adilinden-oss/uino-motor/uino-motor-brd.png

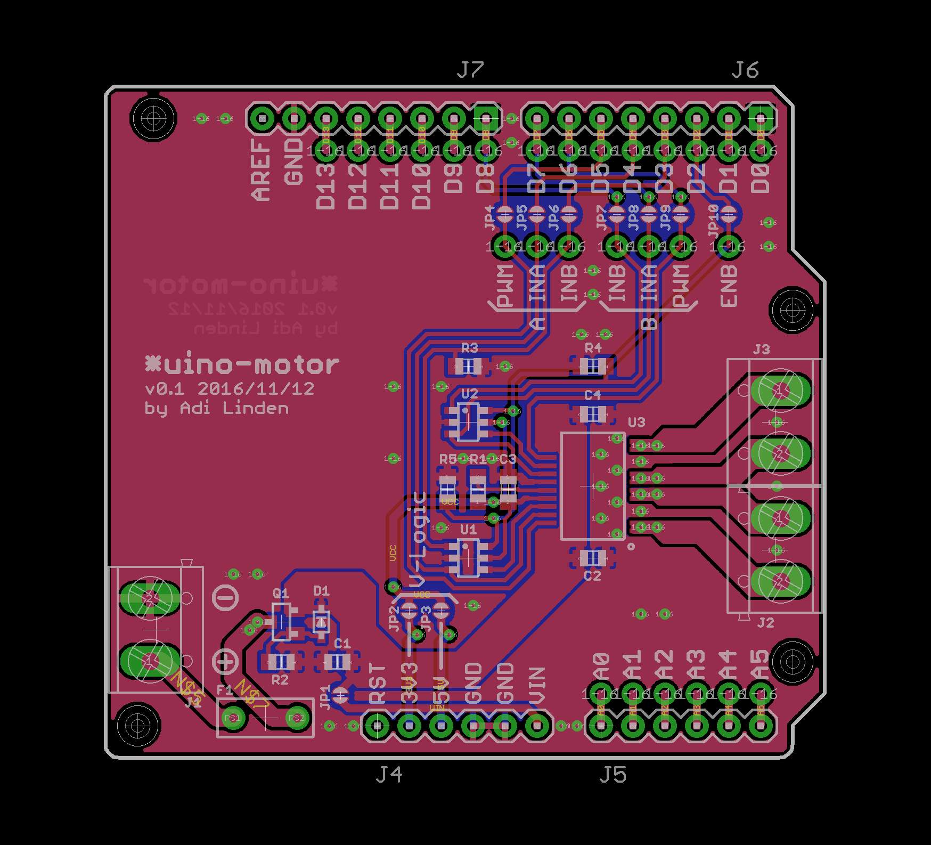
uino-motor-brd.png
