adilinden-oss/uino-motor/uino-motor-sch.png

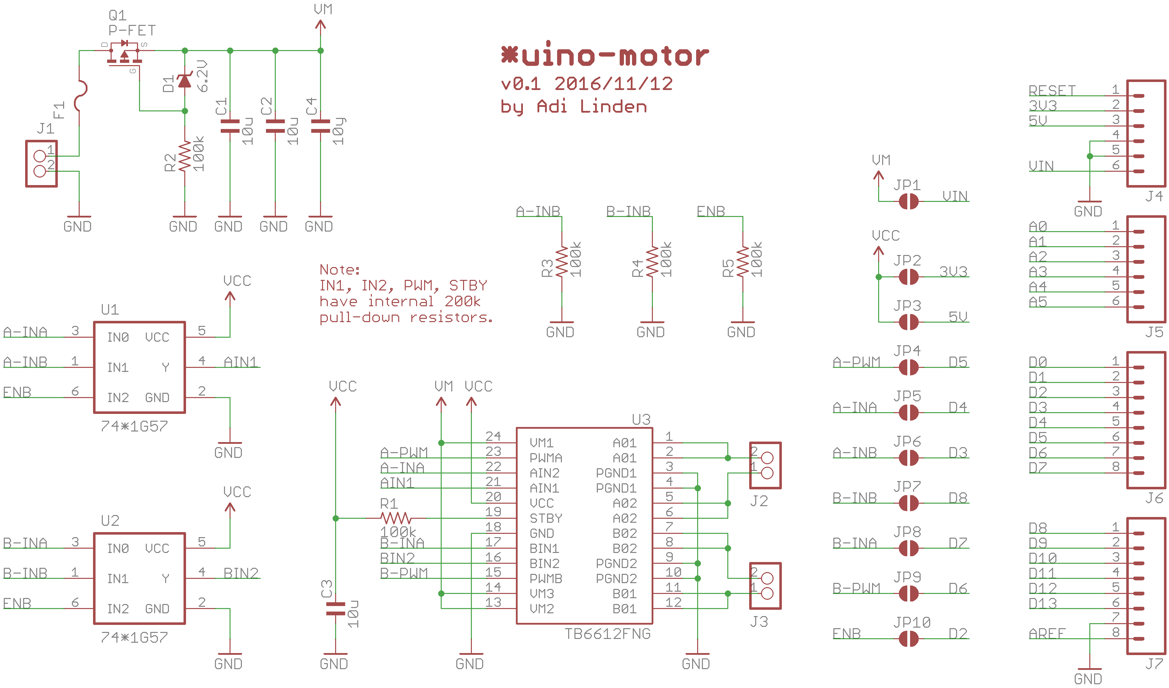
uino-motor-sch.png
