adilinden-oss/uino-motor/uino-motor_bom.xlsx

Parts | Qty | Value | Manufacturer Part Number | DigiKey Part Number | Package | Description
C1, C2, C3,C4 | 3 | 10u | CL21A106KOQNNNG | 1276-6455-1-ND | C0805 | 10µF ±10% 16V Ceramic Capacitor X5R 0805 (2012 Metric)
D1 | 1 | 6.2V Zener | DZ2J062M0L | DZ2J062M0LCT-ND | SOD323 | Zener Diode 6.2V 200mW ±5% Surface Mount SMini2-F5-B
F1 | 1 |  | 0ZRA0300FF1C | 507-1304-ND | 5mm | PTC Resettable Fuse 16V 3A Ih Through Hole Radial, Disc
J1, J2, J3 | 3 | Terminal | OSTTC022162 | ED2609-ND | 7.6x10.16mm | 2 Position Wire to Board Terminal Block Horizontal with Board 0.200" (5.08mm) Through Hole
J4, J5 | 2 | Header 1x6 | PPTC061LFBN-RC | S7004-ND | 1X06 | 6 Position Header Connector 0.100" (2.54mm) Through Hole Tin
J6, J7 | 2 | Header 1x8 | PPTC081LFBN-RC | S7006-ND | 1X08 | 8 Position Header Connector 0.100" (2.54mm) Through Hole Tin
Q1 | 1 | P-FET | SSM3J328R,LF | SSM3J328RLFCT-ND | SOT23 | MOSFET P-CH 20V 6A SOT23F
R1, R2, R3, R4, R5 | 5 | 100k | RC0805JR-07100KL | 311-100KARCT-ND | R0805 | RES SMD 100K OHM 5% 1/8W 0805
U1, U2 | 2 | 74*1G57 | 74LVC1G57W6-7 | 74LVC1G57W6-7CT-ND | SOT23-6 | Configurable Multiple Function Configurable 1 Circuit 3 Input SOT-26
U3 | 1 | TB6612FNG | TB6612FNG,C,8,EL | TB6612FNGC8ELCT-ND | SSOP24 | Motor Driver Power MOSFET Parallel 24-SSOP
