adilinden-oss/uino-motor/uino-motor.brd

## EAGLE design uino-motor.brd (2016-11-17)

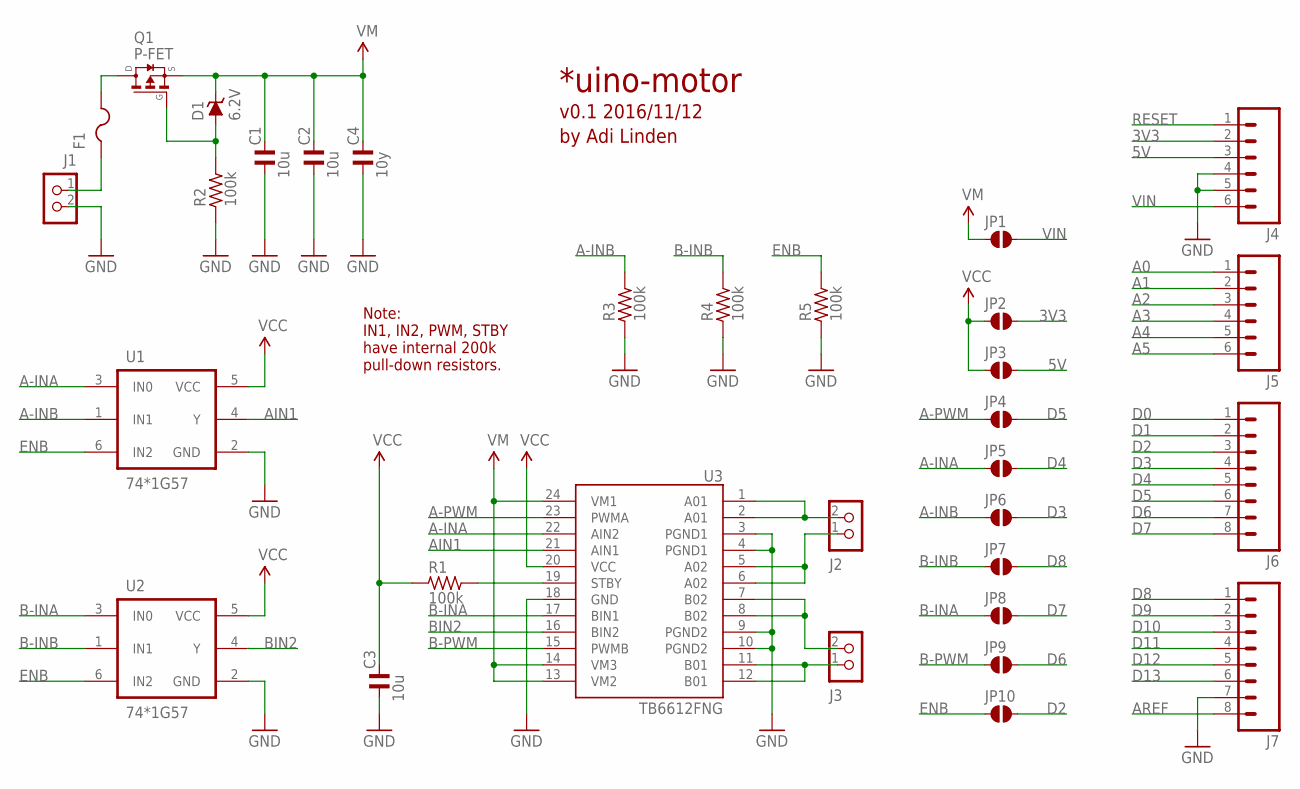
[picture p3: schematic uino-motor.sch]

Parts:
C1, C2, C3: 10u; C0805MP
C4: 10y; C0805MP
D1: 6.2V; SOD323
F1: FUSE_PTC-TH; PTC
J1, J2, J3: CON_TERMINAL_BLOCK_02-5MM; TERMINAL_BLOCK_2P_5
J4, J5: M06SIP; 1X06
J6, J7: M081X08; 1X08
JP1, JP2, JP3, JP4, JP5, JP6, JP7, JP8, JP9, JP10: SJ-035
Q1: P-FET; SOT23
R1, R2, R3, R4, R5: 100k; R0805MP
U1, U2: 74*1G57; SOT23-6
U3: TB6612FNG; SSOP24

Connections:
3V3: J4.2, JP2.2
5V: J4.3, JP3.2
A0: J5.1
A1: J5.2
A01: J2.2, U3.1 (A01), U3.2 (A01)
A2: J5.3
A02: J2.1, U3.5 (A02), U3.6 (A02)
A3: J5.4
A4: J5.5
A5: J5.6
A-INA: JP5.1, U1.3 (IN0), U3.22 (AIN2)
A-INB: JP6.1, R3.2, U1.1 (IN1)
A-PWM: JP4.1, U3.23 (PWMA)
AIN1: U1.4 (Y), U3.21 (AIN1)
AREF: J7.8
B01: J3.1, U3.11 (B01), U3.12 (B01)
B02: J3.2, U3.7 (B02), U3.8 (B02)
B-INA: JP8.1, U2.3 (IN0), U3.17 (BIN1)
B-INB: JP7.1, R4.2, U2.1 (IN1)
B-PWM: JP9.1, U3.15 (PWMB)
BIN2: U2.4 (Y), U3.16 (BIN2)
D0: J6.1
D1: J6.2
D2: J6.3, JP10.2
D3: J6.4, JP6.2
D4: J6.5, JP5.2
D5: J6.6, JP4.2
D6: J6.7, JP9.2
D7: J6.8, JP8.2
D8: J7.1, JP7.2
D9: J7.2
D10: J7.3
D11: J7.4
D12: J7.5
D13: J7.6
ENB: JP10.1, R5.2, U1.6 (IN2), U2.6 (IN2)
GND: C1.1, C2.1, C3.1, C4.1, J1.2, J4.4, J4.5, J7.7, R2.1, R3.1, R4.1, R5.1, U1.2 (GND), U2.2 (GND), U3.3 (PGND1), U3.4 (PGND1), U3.9 (PGND2), U3.10 (PGND2), U3.18 (GND)
unnamed: R1.2, U3.19 (STBY)
unnamed: F1.P$1 (1), J1.1
unnamed: D1.A, Q1.1 (G), R2.2
unnamed: F1.P$2 (2), Q1.3 (D)
RESET: J4.1
VCC: C3.2, JP2.1, JP3.1, R1.1, U1.5 (VCC), U2.5 (VCC), U3.20 (VCC)
VDD: C1.2, C2.2, C4.2, D1.C, JP1.1, Q1.2 (S), U3.13 (VM2), U3.14 (VM3), U3.24 (VM1)
VIN: J4.6, JP1.2

Notes on the sheet:
Note: IN1, IN2, PWM, STBY have internal 200k pull-down resistors.
*uino-motor
v0.1 2016/11/12
by Adi Linden

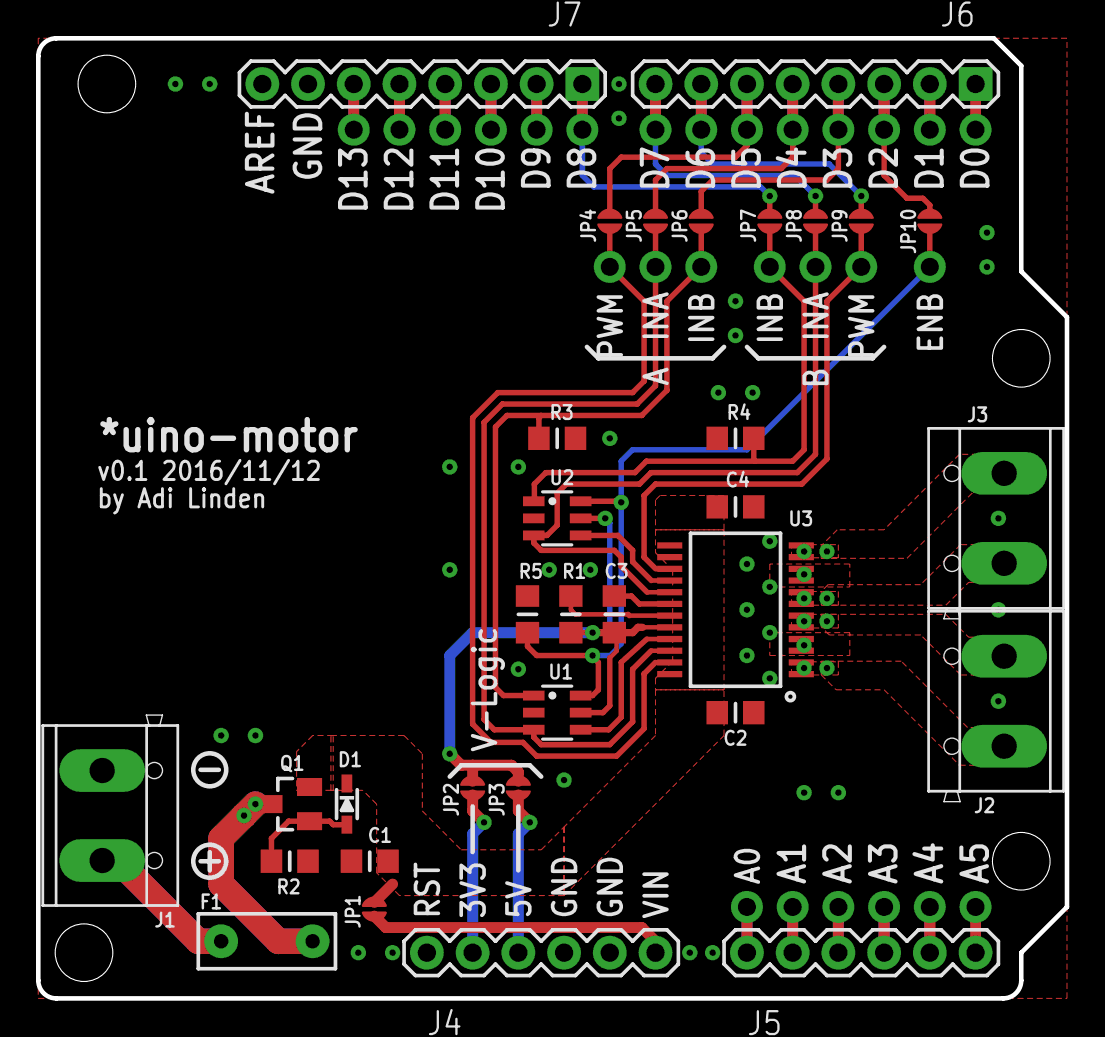
[picture p4: board uino-motor.brd from above]

Board: 2 copper layers, 57.1 x 53.3 mm, 32 parts (0 on the bottom side), 30 nets.
