adilinden-oss/uino-motor/(commit log)

2016-11-10 Added uino-motor.
    [uino-motor.brd, uino-motor.sch]
2016-11-11 Added pull-down at logic gate inputs. Routed board.
    [uino-motor.brd, uino-motor.sch]
2016-11-12 Parts placed and major routing completed.
    [uino-motor.brd, uino-motor.sch]
2016-11-13 Added values. Version 0.1
    [uino-motor.brd, uino-motor.sch]
2016-11-14 Added BOM.
    [uino-motor_bom.xlsx]
2016-11-17 Included *Dcou layers in png.
    [uino-motor.brd]
