adilinden-oss/uino-motor/(notices)

Notices in the files:
parts and their libraries:
74LV: Copyright (C) 2008, Bob Starr
rc-master-smd: Copyright (C) 2007-2008, Bob Starr
jumpers: Copyright (C) 2009, Bob Starr
SparkFun-PowerIC: Licensing: Creative Commons ShareAlike 4.0 International - https://creativecommons.org/licenses/by-sa/4.0
